ealex/sdr/README.md

# sdr

my take on a simple SDR based on http://qrp-labs.com/ receiver module (http://qrp-labs.com/images/receiver/receiver2.pdf) and Compact Si5351 based SDR (https://circuitsalad.com/2020/01/06/compact-si5351-based-sdr/)
