ealex/sdr/documentation/refference/si5351_sdr3.jpg

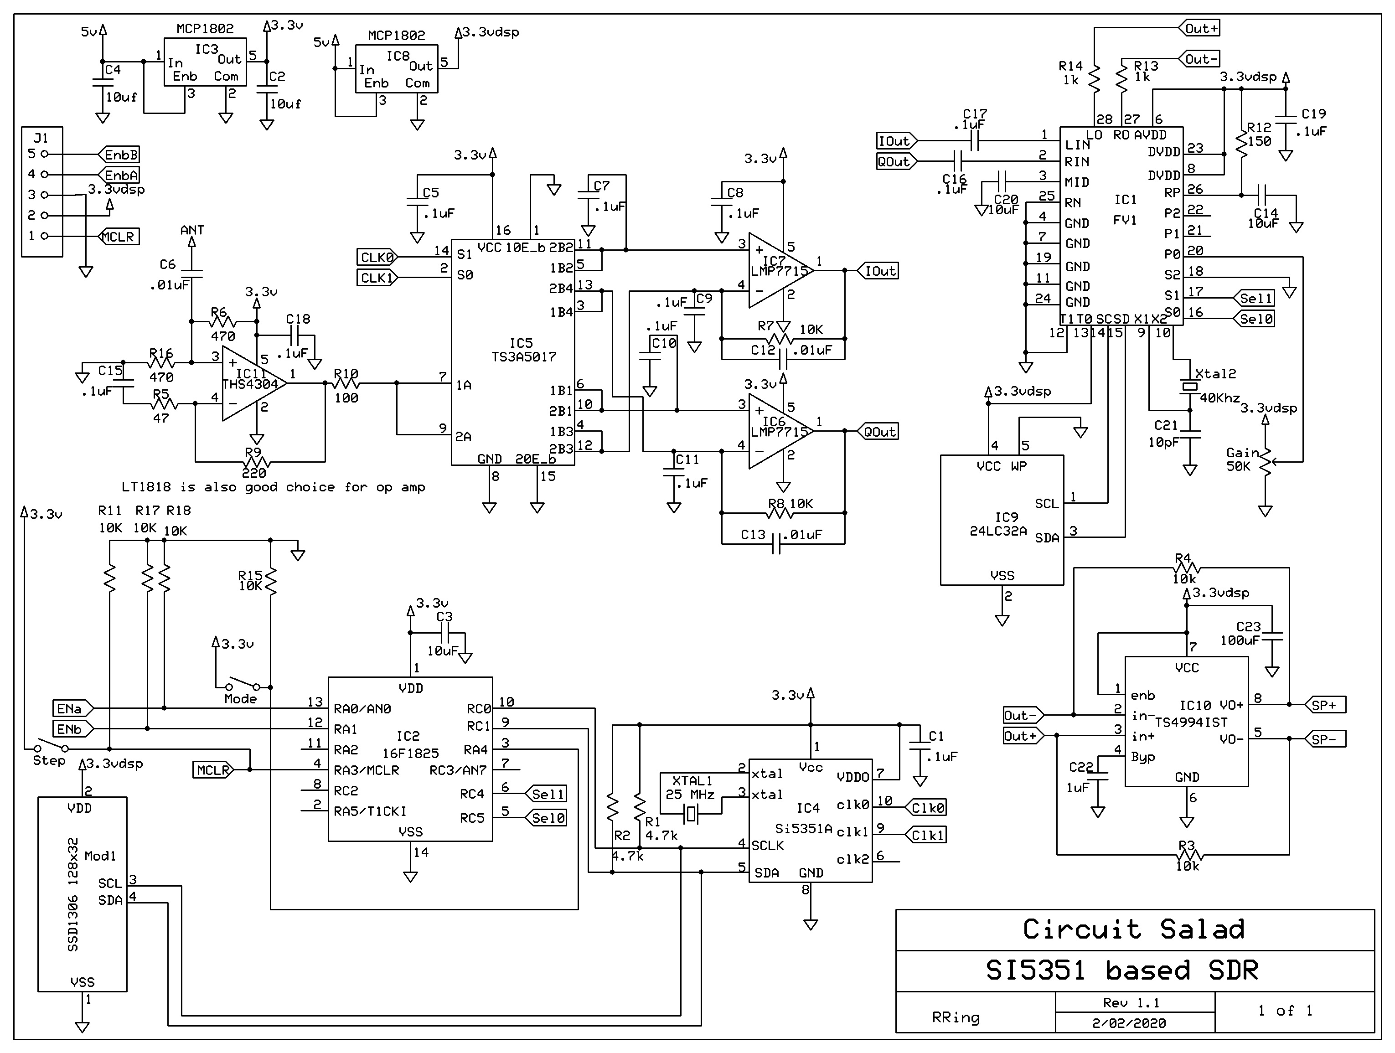
documentation/refference/si5351_sdr3.jpg
