ealex/sdr/hardware/sdr_analogic/3dModels/models-MP-K7805-500R3.step

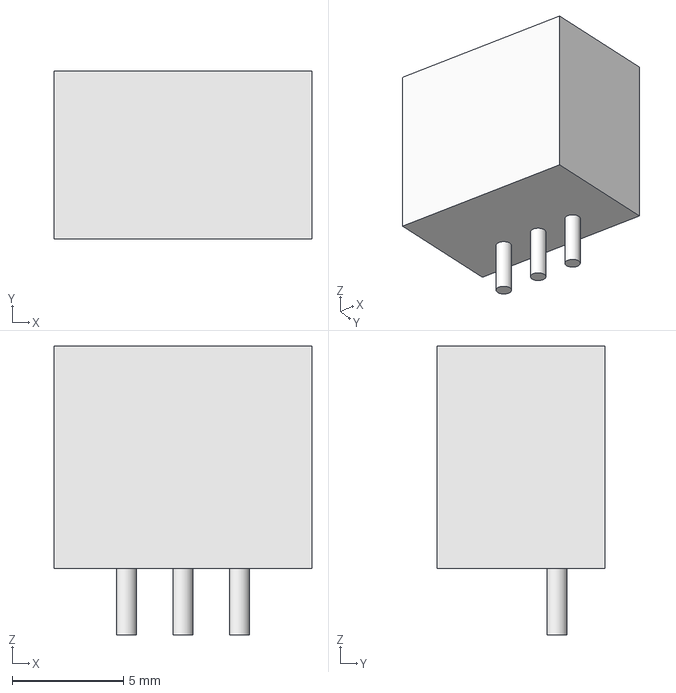
[picture p30: CAD file, 2022-05-26]
hardware/sdr_analogic/3dModels/models-MP-K7805-500R3.step
11.6 x 7.55 x 13.0 mm
