ealex/sdr/hardware/sdr_analogic/3dModels/models-MP008516.step

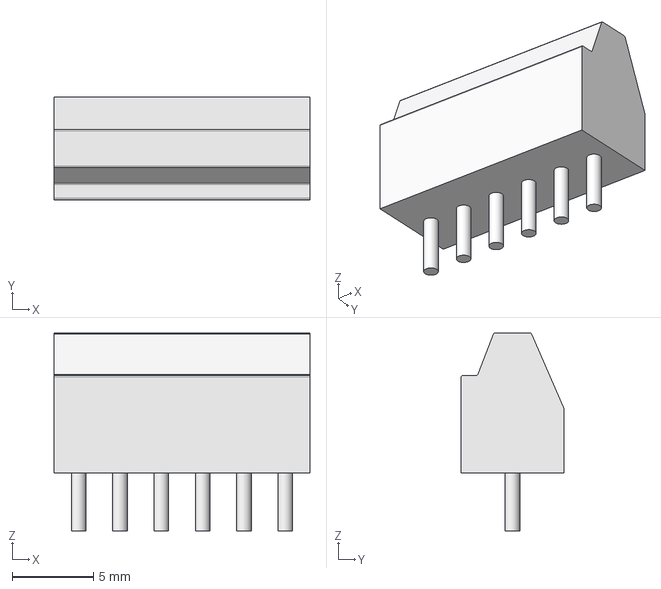
[picture p31: CAD file, 2022-05-26]
hardware/sdr_analogic/3dModels/models-MP008516.step
15.7 x 6.30 x 12.1 mm
