ealex/sdr/hardware/sdr_analogic/3dModels/models-EADOGM128W-6.step

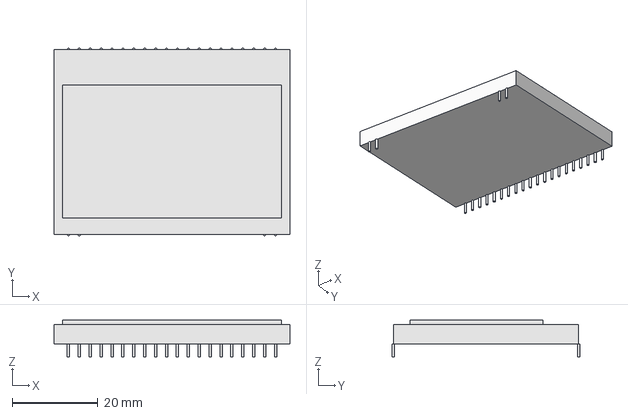
[picture p32: CAD file, 2022-05-26]
hardware/sdr_analogic/3dModels/models-EADOGM128W-6.step
55.0 x 43.8 x 8.60 mm
