ealex/sdr/hardware/sdr_analogic/3dModels/models-EVPASCB1A.step

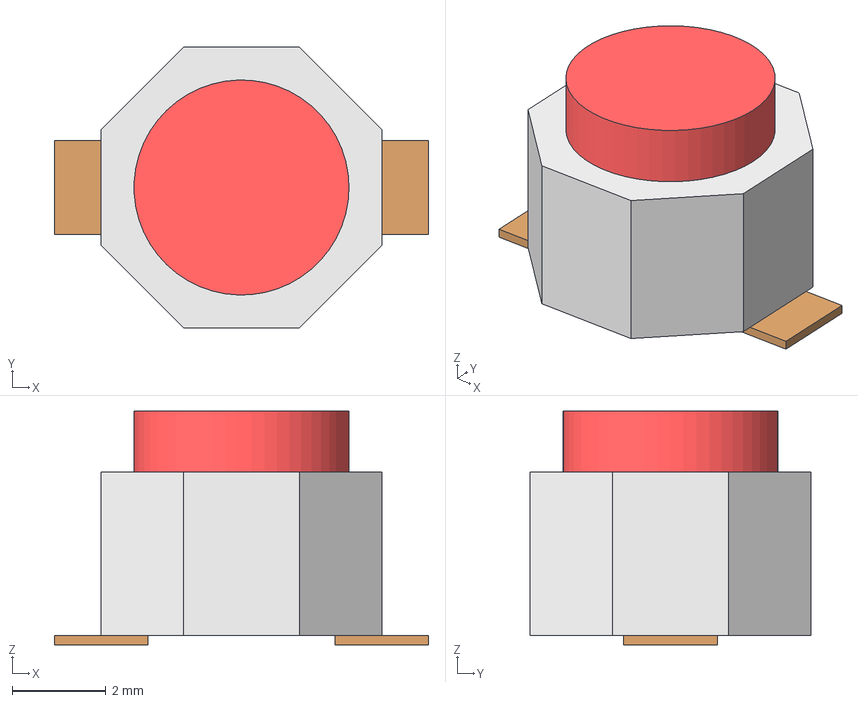
[picture p33: CAD file, 2022-05-26]
hardware/sdr_analogic/3dModels/models-EVPASCB1A.step
8.00 x 6.00 x 5.00 mm
pad_left
pad_right
switch_body
buton
