ealex/sdr/hardware/sdr_analogic/3dModels/models-691213510002.step

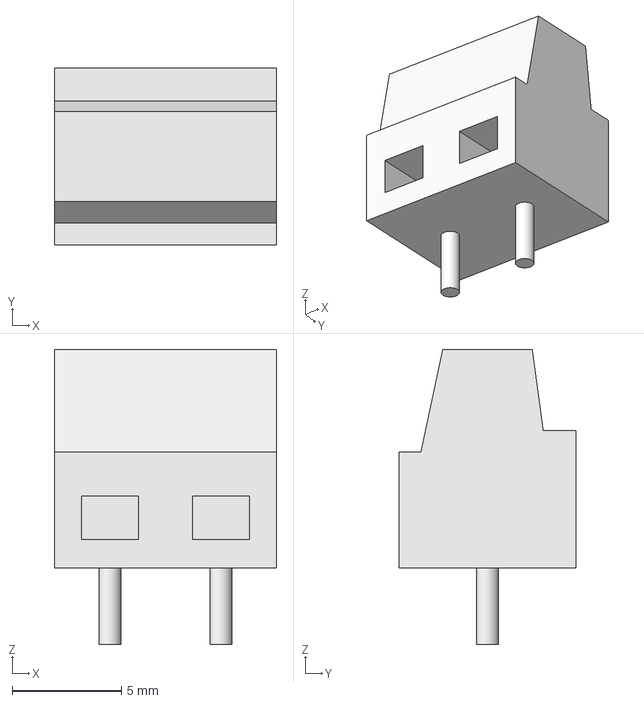
[picture p34: CAD file, 2022-05-26]
hardware/sdr_analogic/3dModels/models-691213510002.step
10.2 x 8.10 x 13.5 mm
