ealex/sdr/(list of files, cad)

Other CAD files:
hardware/sdr_analogic/3dModels/models.FCStd
