ealex/sdr/hardware/sdr_analogic/sdr.pdf

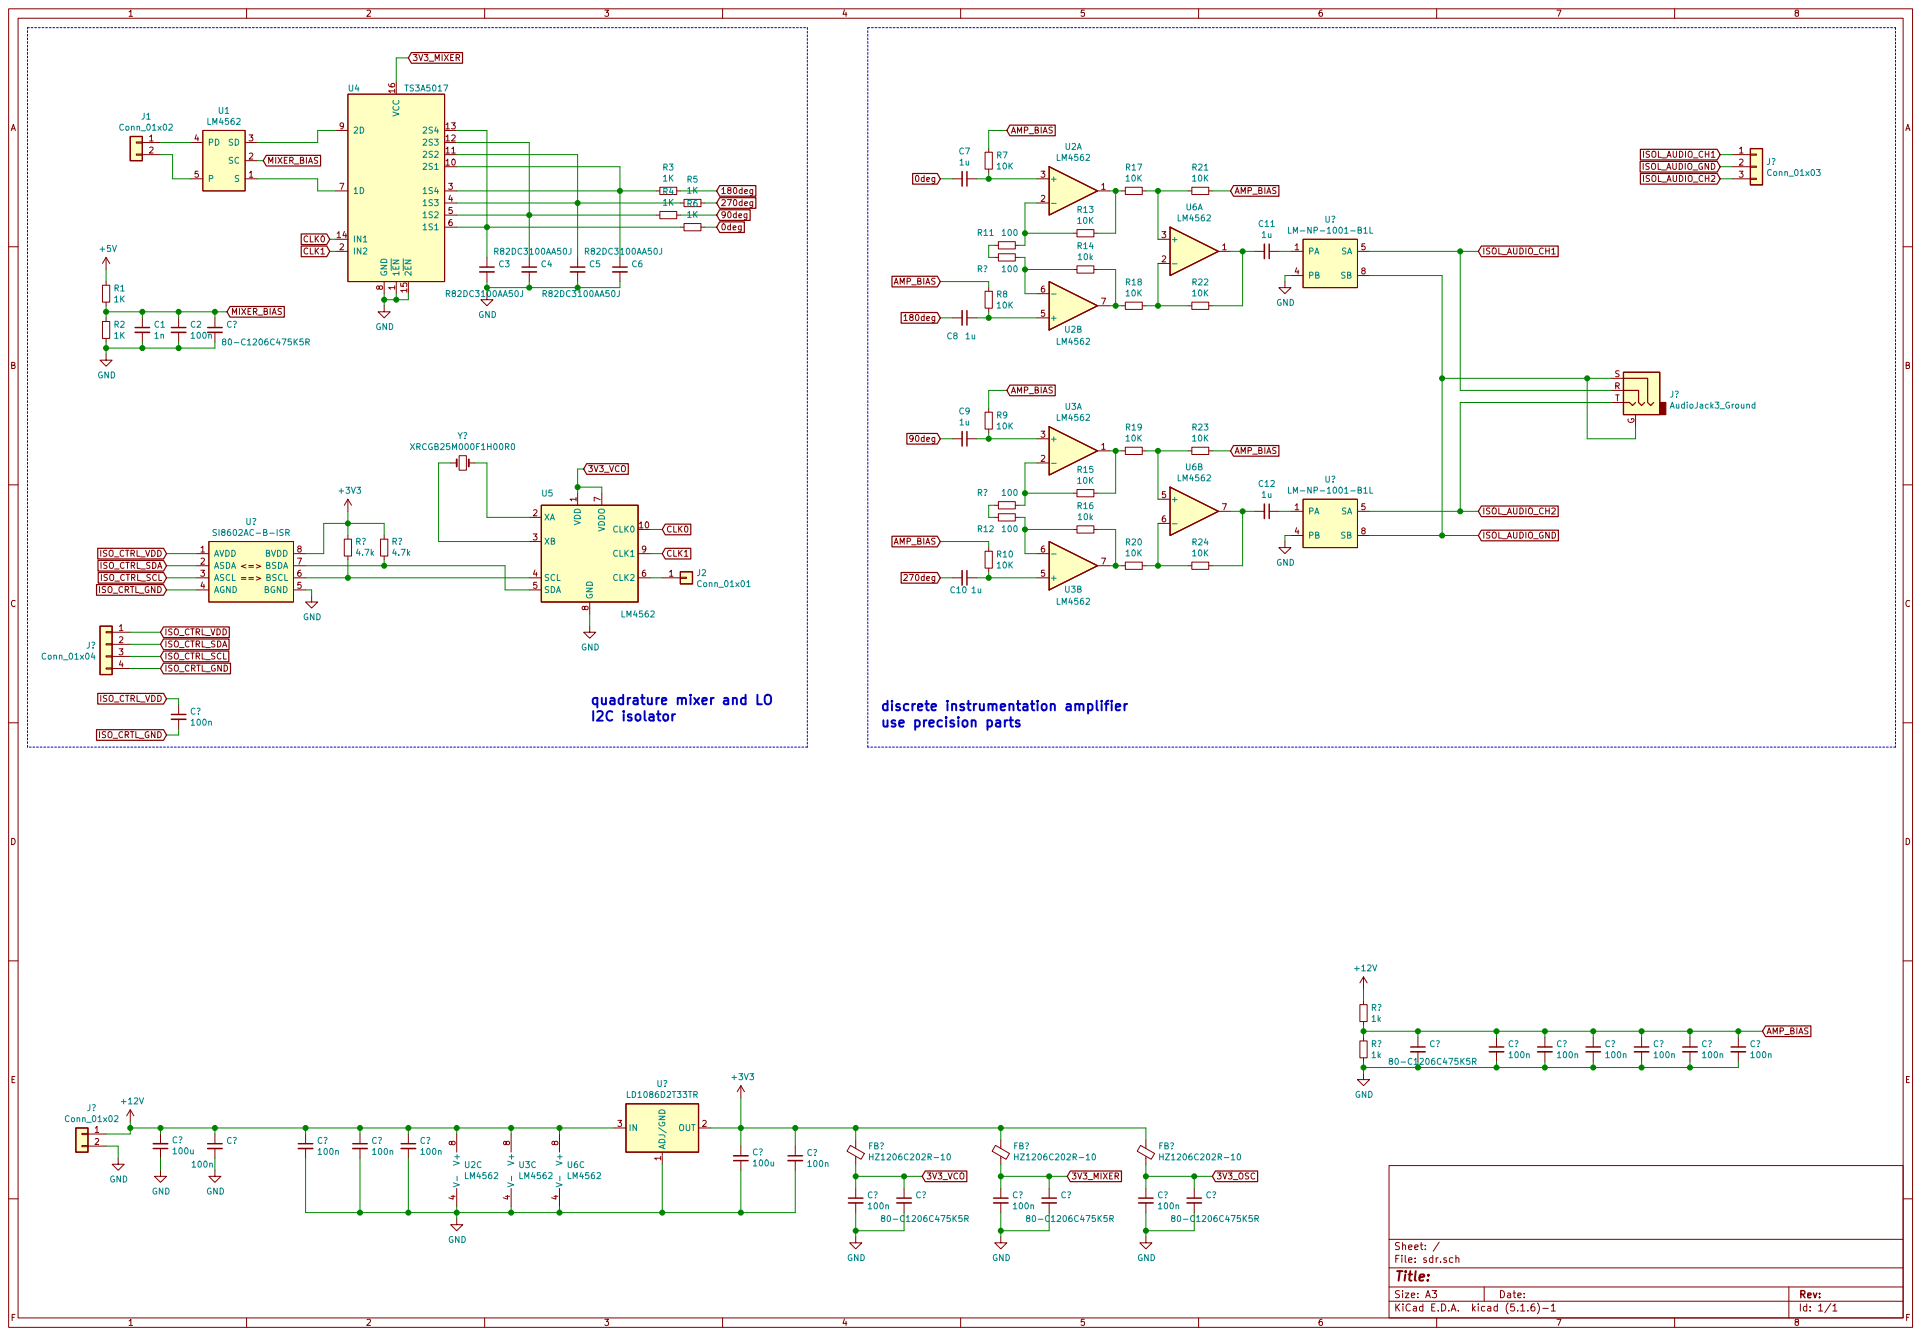
[picture p35: page 1]

1 CLK0 10 XA 2 XB 3 SCL 4 SDA 5 CLK2 6 VDDO

quadrature mixer and LO

Id: 1/1 Title: File: sdr.sch Sheet: /
