ealex/sdr/(commit log)

2020-06-15 add schematic, parts selection almost done
    [sdr.kicad_pcb, sdr.sch]
2020-06-15 schematic update
    [sdr.sch]
2020-07-15 schematic ready for layout
    [sdr.sch]
2022-05-26 remove unused files, migrate to https://github.com/ArjanteMarvelde/uSDR-pico
2022-05-26 redesign projec for https://github.com/ArjanteMarvelde/uSDR-pico
    [audio.sch, audioOut.sch, cpu.sch, mixer.sch, models-691213510002.step, models-EADOGM128W-6.step, models-EVPASCB1A.step, models-MP-K7805-500R3.step]
2022-05-27 add software based on https://github.com/ArjanteMarvelde/uSDR-pico
2022-06-01 add weaver demodulation code - does not work, need to debug
    [dsp.c, hmi.c]
2022-06-01 add an spreadsheed to keep track of filter coeff
    [filterCoeff.ods]
2022-06-01 update code
    [filterCoeff.ods]
